SeanHsu324/ES/樹莓派.md

# 樹莓派 5 使用手冊

大老二 AI 機器手臂在樹莓派 5 上的接線、啟動、Discord `/` 指令與疑難排解。
（Windows 端的錄製與開發流程請看 [README.md](README.md)）

---

## 1. 系統架構

```
                       ┌──────────── 樹莓派 5 ────────────┐
 手牌鏡頭 (USB) ──────►│                                   │
 出牌區鏡頭 (USB) ────►│  main.py                          │──HDMI──► 外接螢幕 (觀眾畫面)
 PASS 按鈕 ──GPIO17──►│   ├ 影像辨識 (手牌、出牌區)         │
                       │   ├ AI 決策 (big_two_best.pth)     │──網路──► Discord
                       │   └ 手臂控制 ──I2C──┐              │          ├ 後臺頻道
                       └─────────────────────┼─────────────┘          └ 牌局頻道
                                             ▼
                                  PCA9685 伺服驅動板
                                  ├ 通道 0~5：手臂 J1~J6
                                  └ 通道 6、7：排夾 J7、J8
```

樹莓派版**不需要 ESP32 和示範臂**：樹莓派用 I2C 直接控制 PCA9685。
動作已經在 Windows + ESP32 + 示範臂錄好，複製過來直接用。樹莓派版**不能錄製新動作**。

---

## 2. 接線

### 2.1 樹莓派 40pin 腳位（只列出會用到的）

**pin 1** 在 40pin 排針**離 USB 孔最遠的那一端、靠板子內側的那一排**（背面焊墊是方形的那一腳）。
奇數腳（1、3、5…）在內側那排，偶數腳（2、4、6…）在靠板子邊緣那排。
不確定的話，在樹莓派終端機輸入 **`pinout`**，會直接畫出這塊板子的腳位圖。

```
           3.3V  (1) ●  ● (2)  5V
  SDA  GPIO2     (3) ●  ● (4)  5V
  SCL  GPIO3     (5) ●  ● (6)  GND
                 (7) ●  ● (8)
            GND  (9) ●  ● (10)
  PASS GPIO17   (11) ●  ● (12)
                     …
```

### 2.2 PCA9685 伺服驅動板

| PCA9685 腳位 | 接到 | 說明 |
|---|---|---|
| **VCC** | 樹莓派 **pin 1（3.3V）** | 驅動板晶片本身的電源（邏輯電壓） |
| **GND** | 樹莓派 **pin 6（GND）** | |
| **SDA** | 樹莓派 **pin 3（GPIO2）** | I2C 資料線 |
| **SCL** | 樹莓派 **pin 5（GPIO3）** | I2C 時脈線 |
| **V+**（綠色端子台） | **外接 5~6V 電源的 +** | 伺服馬達的電源 |
| **GND**（綠色端子台） | **外接電源的 −** | 要和樹莓派**共地**（見下方） |

> ⚠️ **伺服馬達絕對不能從樹莓派取電。** 8 顆伺服同時動，電流會到好幾安培，會讓樹莓派重開機甚至燒壞。
> ⚠️ **一定要共地**：外接電源的 − 和樹莓派的 GND 要相通。PCA9685 板子上兩個 GND 本來就是連通的，所以把 GND 接到樹莓派 pin 6 就完成共地了。
> ⚠️ VCC 接 **3.3V（pin 1）**，不要接 5V。I2C 訊號是 3.3V，接 5V 可能傷到樹莓派的 GPIO。

### 2.3 伺服馬達（接在 PCA9685 上）

| PCA9685 通道 | 馬達 | 說明 |
|---|---|---|
| 0 | J1 | 底座旋轉 |
| 1 | J2 | 大臂 |
| 2 | J3 | 小臂 |
| 3 | J4 | 腕俯仰 |
| 4 | J5 | 腕旋轉 |
| 5 | J6 | 夾爪 |
| 6 | J7 | 第一排排夾（0° 開、90° 關） |
| 7 | J8 | 第二排排夾（90° 開、0° 關） |

插頭方向：**咖啡色（或黑色）線 = GND**，對準 PCA9685 排針上標示 GND 的那一排。紅色 = V+，橘色（或黃色）= 訊號。

### 2.4 PASS 按鈕（自回彈按鈕）

| 按鈕 | 接到 |
|---|---|
| 一腳 | 樹莓派 **pin 11（GPIO17）** |
| 另一腳 | 樹莓派 **pin 9（GND）** |

不用另外加電阻，程式會開啟樹莓派內建的上拉電阻。

### 2.5 鏡頭

兩顆 USB 鏡頭直接插樹莓派的 USB 孔，建議插**藍色的 USB 3.0 孔**，頻寬比較夠。
- 手牌鏡頭：裝在手臂上，拍手牌架。
- 出牌區鏡頭：拍出牌區。

如果兩顆讀反了，用 Discord 的 **`/swapcam`** 互換就好，不用改接線（見第 5 節）。

### 2.6 接好後檢查

在樹莓派的終端機執行：
```bash
i2cdetect -y 1
```
表格裡出現 **`40`**，代表 PCA9685 有接好。全部都是 `--` 的話，請檢查 SDA / SCL 有沒有接反，以及 VCC、GND。

---

## 3. 開機與啟動

### 3.1 已經設定好的系統項目
| 項目 | 狀態 |
|---|---|
| I2C | 已開啟（`/boot/firmware/config.txt`：`dtparam=i2c_arm=on`） |
| 風扇 | 開機就全速轉（同一個檔案最後面的 `BIGTWO_FAN` 區塊） |
| Python 環境 | `~/ES/venv`（PyTorch、OpenCV、Discord 等都裝好了） |
| 程式位置 | `~/ES` |
| 桌面捷徑 | 桌面上的 **「大老二 AI」** |

原本的 `config.txt` 備份在 `/boot/firmware/config.txt.bak-日期`。

### 3.2 啟動
1. **先開伺服馬達的外接電源**，再開樹莓派（或已開機也可以）。
2. 雙擊桌面的 **「大老二 AI」**。
3. 會開一個終端機視窗（顯示系統訊息），外接螢幕則全螢幕顯示**觀眾畫面**。
4. Discord 上機器人 `A2C手臂` 會上線，後臺頻道會開始出現訊息。

> ⚠️ 伺服板**剛上電**時，程式不知道手臂在哪，第一個動作（回初始點）會**直接跳到定位**。啟動前手要離開手臂。
> 之後只要伺服板一直有電，重開程式時會讀回上次的角度，從原位平滑出發。

### 3.3 關閉
- Discord 輸入 **`/shutdown`**，或
- 在終端機視窗按 **Ctrl+C**。

程式結束後，終端機會顯示「按 Enter 關閉視窗」。

---

## 4. 觀眾畫面（外接螢幕）

給所有人看的遊戲畫面，**不顯示任何人的手牌**：

| 位置 | 內容 |
|---|---|
| 左上角 | **紅黃綠狀態燈** |
| 上下左右 | 4 家（AI / P2 / P3 / P4）的牌背和**剩餘張數** |
| 中間 | 出牌區**已出過的總張數** |
| 右下角 | 出牌區鏡頭即時畫面 |

- **輪到誰**：那一家的數字外圈會發金光。
- **PASS**：這一回合已經 Pass 的人會標 `PASS`。
- **獲勝**：出完牌的人旁邊會出現皇冠。

### 狀態燈
| 燈號 | 意思 | 要做什麼 |
|---|---|---|
| 🟢 綠 | 全自動正常進行中 | 不用管 |
| 🟡 黃 | 處理中（手臂動作、拍照、辨識），或還沒開始全自動、等你確認 | 照 Discord 提示操作，或等它跑完 |
| 🔴 紅 | **需要人處理**：緊急停止中、手臂驅動板沒接上、出牌區鏡頭沒畫面 | 看後臺頻道的訊息，排除問題 |

### 現場緊急停止
Discord 會有延遲，所以保留一個實體按鍵：在觀眾畫面上按 **`Esc`**，手臂立刻停止。
解除要用 Discord 的 `/resume`。

---

## 5. Discord `/` 指令

### 5.1 頻道
| 頻道 | 用途 |
|---|---|
| **後臺** `#後台-bot` | 所有系統訊息（等於終端機的輸出）、錯誤、辨識結果 |
| **牌局** `#局` | 公開的出牌紀錄，例如「P2 出牌 ♠9 ♥9（剩 11 張）」。**開新局時會清空** |

- **誰能用指令**：只有擁有**主人身分組（@呵）**的成員可以使用。其他人使用會看到「只有主人可以使用這個指令」。
- **回覆可見範圍**：所有指令的回覆**只有下指令的人看得到**，所以在牌局頻道下指令也不會洗版。

### 5.2 開局用
| 指令 | 說明 |
|---|---|
| **`/newgame`** | 開新局：**清空牌局頻道**、重設所有狀態、**打開排夾**（讓你插牌） |
| **`/start`** | 手臂依序到第一排、第二排拍照辨識手牌 → 回初始點 → **排夾關閉** → 辨識完整就**自動開始全自動對戰**。手牌已經鎖定時，直接開始全自動 |
| `/start first:P2` | 同上，並直接指定「AI 沒有梅花 3 時，誰先出」 |
| **`/first player`** | AI 沒有梅花 3 時，指定誰有梅花 3（P2 / P3 / P4） |
| `/scan` | 只拍照辨識手牌，不自動開始（想先檢查辨識結果時用） |
| `/fix slot card` | 修正辨識錯的某一格，例如 `slot:5 card:SA`。牌名規則見 5.6 |
| `/confirm` | 確認手牌（`/scan` + `/fix` 之後用），會關閉排夾 |

### 5.3 對戰中
| 指令 | 說明 |
|---|---|
| `/auto on:True` / `/auto on:False` | 全自動開 / 關 |
| `/read` | 手動模式：辨識出牌區的牌，結果顯示在後臺 |
| `/submit` | 手動模式：把 `/read` 辨識到的牌，當成現在輪到的對手出的牌 |
| `/aiplay` | 手動模式：輪到 AI 時，讓 AI 出牌 |

### 5.4 Pass 按鈕（取代 `/pass`）
每次換人，牌局頻道會公告「👉 輪到 P3」。輪到對手時，下面附一顆 **✋ Pass 按鈕**，按下就是那一家 Pass。
- 換人之後，上一則的按鈕會自動消失；按到過期的按鈕會回覆「已經過期」，不會誤判。
- 預設只有主人身分組能按。要讓頻道裡所有人都能按，把 `config.py` 的 `DISCORD_PASS_BUTTON_ANYONE` 改成 `True`。

```
👉 輪到 P3
[ ✋ Pass ]      ← 按這個 = P3 Pass
```

### 5.5 系統
| 指令 | 說明 |
|---|---|
| **`/stop`** | ⛔ **緊急停止**：手臂停在原地，全自動關閉 |
| `/resume` | 解除緊急停止，手臂回到初始點。全自動要再用 `/start` 開啟 |
| `/clamp action` | 排夾開 / 關（全自動中不能開） |
| **`/status`** | 查看系統狀態：燈號、手臂、排夾、鏡頭編號、輪到誰、4 家張數、上一手、**AI 手牌**（只有你看得到） |
| **`/swapcam`** | **手牌鏡頭和出牌區鏡頭互換**。兩顆 USB 鏡頭讀反時用，會自動存進 `.env`，下次開機也是對的 |
| `/shutdown` | 關閉主程式 |

### 5.6 牌名規則（`/fix` 用）
花色字母 + 點數，例如：
- 花色：`C` 梅花、`D` 方塊、`H` 紅心、`S` 黑桃
- 點數：`3 4 5 6 7 8 9 10 J Q K A 2`（10 可以打 `10` 或 `T`）
- 例：`C3` 梅花 3、`H10` 紅心 10、`SA` 黑桃 A、`D2` 方塊 2

### 5.7 一局的標準流程
1. `/newgame`：牌局頻道清空，排夾打開。
2. 把 13 張牌插進手牌架：**第一排 8 張、第二排 5 張**。
3. `/start`：自動拍照辨識，完成後開始全自動。
   - AI 沒有梅花 3 → 後臺會提示，用 `/first` 指定。
   - 辨識有錯 → 後臺會提示，用 `/status` 看、`/fix` 改、`/confirm` 確認，再 `/start`。
4. 對戰：
   - 輪到 AI：手臂自動夾牌、往前丟。
   - 輪到對手：對手把牌**正面朝上**放進出牌區、手移開，系統自動辨識。
   - 對手要 Pass：按實體 **PASS 按鈕**，或按牌局頻道「輪到 Px」下面的 **✋ Pass**。出牌區 15 秒沒動靜也會自動判 Pass。
5. 有人出完牌 → 觀眾畫面顯示皇冠，牌局頻道公布獲勝者。
6. 下一局回到步驟 1。

---

## 6. 檢查鏡頭有沒有讀反

1. 啟動後看觀眾畫面**右下角**：應該是**出牌區**的畫面。
2. 如果顯示的是手牌架（手臂上的鏡頭畫面）→ 在 Discord 打 **`/swapcam`**。
3. `/status` 會顯示目前兩顆鏡頭的編號，例如「鏡頭：手牌 2 ✅ / 出牌區 0 ✅」。

鏡頭設定存在 `~/ES/.env` 的 `HAND_CAMERA`、`PLAY_CAMERA` 這兩行。

---

## 7. 更新程式

在 **Windows** 的 ES 資料夾執行：
```powershell
powershell -File pi\deploy.ps1 -PiHost pi.local
```
- `pi.local` 連不到時，改用樹莓派的 IP。在樹莓派終端機輸入 `hostname -I` 可以查到。
- 樹莓派上的 `.env`（金鑰、Discord token、鏡頭設定）**不會被覆蓋**。真的要覆蓋，加 `-CopyEnv`。
- 桌面捷徑也會一起更新。
- 更新後要重新啟動「大老二 AI」才會生效。

---

## 8. 疑難排解

| 狀況 | 原因 / 處理 |
|---|---|
| 狀態燈紅色，後臺說「找不到 PCA9685」 | 驅動板沒接好。執行 `i2cdetect -y 1` 看有沒有 `40`，檢查 SDA / SCL / VCC / GND（第 2.2 節） |
| 狀態燈紅色，鏡頭開不起來 | USB 鏡頭沒插好，或編號不對。`/status` 看是哪一顆 ❌ |
| 觀眾畫面右下角是手牌架 | 鏡頭讀反了，用 `/swapcam` |
| 手臂動到一半樹莓派重開機 / 後臺說「ESP32 重新開機」 | 伺服電源不夠，或伺服電源和樹莓派共用。換更大的外接電源，並確認伺服沒有從樹莓派取電 |
| 手臂抖動、沒力 | 外接電源電壓或電流不足（建議 5~6V、5A 以上） |
| `/` 指令打不出來 | 機器人沒上線：確認「大老二 AI」有在跑、樹莓派有連網路。剛開機要等十幾秒 |
| 指令回覆「只有主人可以使用」 | 你的帳號沒有 **@呵** 身分組 |
| `/newgame` 沒有清空牌局頻道 | 機器人需要「管理訊息」權限 |
| 對手出牌沒被偵測到 | 牌要正面朝上、手要移開。還是不行就用 `/read` + `/submit` 手動輸入 |
| 還沒出牌就被判 Pass | 對手 15 秒內沒有動作。可以在 `main.py` 調高 `PASS_TIMEOUT_SEC` |
| 辨識一直失敗 | 網路斷線或辨識服務忙線。技術細節在 `~/ES/logs/vision.log` |
| 風扇不轉 / 不是全速 | 檢查 `config.txt` 最後的 `BIGTWO_FAN` 區塊，改完要重開機 |

### 常用檔案位置
| 檔案 | 位置 |
|---|---|
| 程式 | `~/ES/` |
| 個人設定（金鑰、token、鏡頭） | `~/ES/.env`（不要分享給別人） |
| 動作檔 | `~/ES/actions/` |
| 拍手牌的照片 | `~/ES/webcam_snapshots/` |
| 辨識紀錄 | `~/ES/logs/vision.log` |
| 系統開機設定 | `/boot/firmware/config.txt` |

---

## 9. 安全提醒
- **伺服電源一定外接**，絕對不從樹莓派取電。
- 啟動程式前，手要離開手臂。
- 有任何異常，馬上按觀眾畫面的 **`Esc`**，或用 Discord 的 **`/stop`**。
- `.env` 裡有 Gemini 金鑰和 Discord token，**不要上傳或分享**。
- sudo 密碼曾經貼在對話裡，建議用 `passwd` 改掉。
