SeanHsu324/ES/vision.py

"""
鏡頭 + Gemini 辨識 (main.py / record.py 共用)
"""
import os
import sys
import json
import time
import threading

import cv2
import numpy as np

from config import (
    CAMERA_WIDTH, CAMERA_HEIGHT, GEMINI_MODELS, GEMINI_TIMEOUT_SEC, HAND_ROI, PLAY_ROI,
    HAND_ZONES, NUM_SLOTS, PHOTO_SETTLE_SEC, HAND_REVERSED, SNAPSHOT_DIR,
)
from robot_arm import HOME
from config import BASE_DIR

# 辨識服務的技術細節 (模型、回應時間、錯誤) 只寫進本機 logs/vision.log，不顯示在終端機 / Discord
import logging
os.makedirs(os.path.join(BASE_DIR, 'logs'), exist_ok=True)
vlog = logging.getLogger('vision')
vlog.setLevel(logging.INFO)
vlog.propagate = False
if not vlog.handlers:
    _h = logging.FileHandler(os.path.join(BASE_DIR, 'logs', 'vision.log'), encoding='utf-8')
    _h.setFormatter(logging.Formatter('%(asctime)s %(levelname)s %(message)s'))
    vlog.addHandler(_h)

# =====================================================
# 牌名 <-> 編號
# =====================================================
# 0-12: 梅花(C), 13-25: 方塊(D), 26-38: 紅心(H), 39-51: 黑桃(S)
SUIT_ORDER = ['C', 'D', 'H', 'S']
RANK_ORDER = ['3', '4', '5', '6', '7', '8', '9', 'T', 'J', 'Q', 'K', 'A', '2']
CARD_NAMES = [s + r for s in SUIT_ORDER for r in RANK_ORDER]  # 規定名稱，例: C3, DT, SA, H2


def get_card_id(name):
    """牌名 -> 1~52，無法辨識回傳 None"""
    if not isinstance(name, str):
        return None
    name = name.strip().upper().replace('10', 'T')
    if len(name) != 2:
        return None
    s, r = name[0], name[1]
    if s not in SUIT_ORDER or r not in RANK_ORDER:
        return None
    return SUIT_ORDER.index(s) * 13 + RANK_ORDER.index(r) + 1


def id_to_card_name(card_id):
    if not (1 <= card_id <= 52): return "??"
    return f"{SUIT_ORDER[(card_id-1)//13]}{RANK_ORDER[(card_id-1)%13]}"


def names_str(ids):
    return " ".join(id_to_card_name(c) for c in sorted(ids))


def crop(frame, roi):
    if roi is None:
        return frame
    h, w = frame.shape[:2]
    x, y, rw, rh = roi
    return frame[int(y*h):int((y+rh)*h), int(x*w):int((x+rw)*w)]


def draw_roi(img, roi, color):
    if roi is None:
        return
    h, w = img.shape[:2]
    x, y, rw, rh = roi
    cv2.rectangle(img, (int(x*w), int(y*h)), (int((x+rw)*w), int((y+rh)*h)), color, 2)


def put_text(img, text, y, scale, color, thick, x=20):
    cv2.putText(img, text, (x, y), cv2.FONT_HERSHEY_PLAIN, scale, color, thick)


# =====================================================
# 鏡頭 (背景持續讀取，永遠拿到最新畫面)
# =====================================================
def _camera_backend():
    # Windows: DirectShow；樹莓派 / Linux: V4L2
    return cv2.CAP_DSHOW if sys.platform == 'win32' else cv2.CAP_V4L2


class Camera:
    def __init__(self, index, name):
        self.index = index
        self.name = name
        self.cap = None
        self.ok = False
        self._frame = None
        self._frame_time = 0.0
        self._lock = threading.Lock()
        self._running = False
        if index is None:
            print(f"[鏡頭] {name} 未設定，略過")
            return
        # index 可以是編號 (0, 1, 2…) 或 Linux 裝置路徑 (/dev/v4l/by-id/...)
        self.cap = cv2.VideoCapture(index, _camera_backend())
        # MJPG 壓縮：兩顆 USB 鏡頭同時跑 1280x720 未壓縮畫面時頻寬不夠，會卡頓
        self.cap.set(cv2.CAP_PROP_FOURCC, cv2.VideoWriter_fourcc(*'MJPG'))
        self.cap.set(cv2.CAP_PROP_FRAME_WIDTH, CAMERA_WIDTH)
        self.cap.set(cv2.CAP_PROP_FRAME_HEIGHT, CAMERA_HEIGHT)
        self.ok = self.cap.isOpened()
        self._running = self.ok
        if self.ok:
            threading.Thread(target=self._loop, daemon=True).start()
            print(f"[鏡頭] {name} (編號 {index}) 已開啟")
        else:
            print(f"[鏡頭] ❌ {name} (編號 {index}) 開不起來，請用 record.py 的 cams 指令確認編號")

    def _loop(self):
        while self._running:
            try:
                ret, frame = self.cap.read()
            except cv2.error:
                ret, frame = False, None
            if ret and frame is not None and frame.size > 0:
                with self._lock:
                    self._frame = frame
                    self._frame_time = time.time()
            else:
                time.sleep(0.01)

    def age(self):
        """距離上一張新畫面幾秒 (鏡頭卡住或被拔掉時會一直變大)"""
        return time.time() - self._frame_time if self._frame_time else float('inf')

    def read(self):
        """最新畫面 (可能為 None)"""
        with self._lock:
            return None if self._frame is None else self._frame.copy()

    def fresh(self, timeout=2.0):
        """等一張「呼叫之後才拍到」的畫面 (手臂剛停下時用，避免拿到移動中的舊畫面)"""
        t0 = time.time()
        while time.time() - t0 < timeout:
            with self._lock:
                if self._frame is not None and self._frame_time > t0 + 0.05:
                    return self._frame.copy()
            time.sleep(0.01)
        return self.read()

    def release(self):
        self._running = False
        time.sleep(0.05)
        if self.cap is not None:
            self.cap.release()


def probe_cameras(max_index=6, skip=()):
    """
    列出可以開啟的鏡頭。
    Windows: 編號 0~max_index；Linux: /dev/v4l/by-id/ 下的 USB 鏡頭 (固定名稱，建議寫進 .env)
    """
    if sys.platform == 'win32':
        candidates = list(range(max_index))
    else:
        import glob
        candidates = sorted(glob.glob('/dev/v4l/by-id/*-video-index0')) or \
            sorted(glob.glob('/dev/video*'), key=lambda d: int(d[len('/dev/video'):] or 0))[:12]
    found = []
    for dev in candidates:
        if dev in skip:
            found.append((dev, '使用中'))
            continue
        cap = cv2.VideoCapture(dev, _camera_backend())
        if cap.isOpened():
            ret, frame = cap.read()
            if ret:
                found.append((dev, f"{frame.shape[1]}x{frame.shape[0]}"))
        cap.release()
    return found


# =====================================================
# Gemini 辨識 (只在需要時呼叫)
# =====================================================
RULES = (
    "Card naming rule: suit letter + rank letter, exactly 2 characters.\n"
    "Suits: C=Clubs, D=Diamonds, H=Hearts, S=Spades.\n"
    "Ranks: 3 4 5 6 7 8 9 T(=10) J Q K A 2.\n"
    "Examples: 'C3' = 3 of clubs, 'DT' = 10 of diamonds, 'SA' = ace of spades, 'H2' = 2 of hearts.\n"
)

HAND_PROMPT = (
    "This image shows exactly {n} playing cards standing upright, face visible, in a single row "
    "inside a card holder rack. Cards may overlap slightly; read the rank/suit index in each card's corner.\n"
    + RULES +
    "List every card strictly from LEFT to RIGHT as they appear in the image. "
    "The array must have exactly {n} entries, one per card position, no duplicates. "
    "Return only the JSON array."
)

PLAY_PROMPT = (
    "This image shows the play area of a card game table.\n"
    + RULES +
    "List every distinct face-up card whose rank and suit you can identify, from left to right. "
    "Return only the JSON array. If there are no cards, return []."
)


class GeminiCardReader:
    def __init__(self, models=GEMINI_MODELS):
        from google import genai
        from google.genai import types
        self.types = types
        api_key = os.environ.get('GEMINI_API_KEY', '').strip()   # config.py 已從 .env 載入
        if not api_key:
            raise RuntimeError("找不到 GEMINI_API_KEY，請在 ES/.env 寫入一行 GEMINI_API_KEY=你的key")
        # 不讓 SDK 自己重試 (伺服器忙線時會卡好幾分鐘)，改由這裡換模型
        self.client = genai.Client(api_key=api_key, http_options=types.HttpOptions(
            timeout=int(GEMINI_TIMEOUT_SEC * 1000),
            retry_options=types.HttpRetryOptions(attempts=1),
        ))
        self.models = list(models)
        self.model = self.models[0]   # 最近一次成功的模型，下次優先用
        self.schema = types.Schema(
            type=types.Type.ARRAY,
            items=types.Schema(type=types.Type.STRING, enum=CARD_NAMES),
        )

    def _ask(self, image, prompt):
        ok, jpg = cv2.imencode('.jpg', image, [cv2.IMWRITE_JPEG_QUALITY, 90])
        if not ok:
            raise RuntimeError("影像編碼失敗")
        types = self.types
        contents = [types.Part.from_bytes(data=jpg.tobytes(), mime_type='image/jpeg'), prompt]
        config = types.GenerateContentConfig(
            response_mime_type='application/json',
            response_schema=self.schema,
            thinking_config=types.ThinkingConfig(thinking_level='low'),  # 認牌不需要深度思考，快很多
        )
        order = [self.model] + [m for m in self.models if m != self.model]
        errors = []
        for model in order:
            t0 = time.time()
            try:
                resp = self.client.models.generate_content(model=model, contents=contents, config=config)
                names = [n.strip().upper() for n in json.loads(resp.text)]
            except Exception as e:
                msg = str(e).split('.')[0][:80]
                errors.append(f"{model}: {msg}")
                vlog.warning(f"{model} 失敗 ({time.time()-t0:.0f}s): {msg}")
                continue
            if model != self.model:
                vlog.info(f"改用 {model}")
                self.model = model
            vlog.info(f"{model} 回應 {time.time()-t0:.1f}s -> {names}")
            return names
        vlog.error("全部失敗: " + " | ".join(errors))
        raise RuntimeError("辨識服務暫時無法使用，請稍後再試")

    def read_hand(self, frame, n):
        """回傳該排由左到右的牌名陣列 (長度應為 n)"""
        return self._ask(crop(frame, HAND_ROI), HAND_PROMPT.format(n=n))

    def read_played(self, frame):
        """回傳出牌區看得到的所有牌名"""
        return self._ask(crop(frame, PLAY_ROI), PLAY_PROMPT)


def save_snapshot(frame, tag):
    os.makedirs(SNAPSHOT_DIR, exist_ok=True)
    path = os.path.join(SNAPSHOT_DIR, f"{tag}_{time.strftime('%Y%m%d_%H%M%S')}.jpg")
    cv2.imwrite(path, frame)
    return path


def capture_zone(robot, hand_cam, zone):
    """手臂移到該排拍照點 -> 等穩定 -> 拍照。失敗回傳 None"""
    pose = zone['pose']
    if not robot.has_action(pose):
        print(f"[手牌] ❌ 缺少拍照點 {pose}，請用 record.py 設定")
        return None
    if not robot.run_sequence([pose], return_home=False):
        return None
    robot.wait()
    if robot.abort.is_set() or not robot.last_ok:
        print(f"[手牌] ❌ 手臂沒有到達拍照點 {pose}，停止辨識 (請檢查手臂與電源)")
        return None
    time.sleep(PHOTO_SETTLE_SEC)
    frame = hand_cam.fresh()
    if frame is not None:
        save_snapshot(frame, pose)
    return frame


def read_zone(reader, frame, zone):
    names = reader.read_hand(frame, zone['count'])
    print(f"[影像辨識] {zone['label']} 由左到右: {names}")
    names = (names + ['??'] * zone['count'])[:zone['count']]
    return names[::-1] if HAND_REVERSED else names


def scan_hand(robot, hand_cam, reader):
    """
    依序到每一排的拍照點拍照並辨識，回初始點後關閉排夾。
    回傳 (13 個牌名，依格子 1~13 排列, 是否完整可用)；手臂中斷回傳 (None, False)
    """
    all_names = []
    for zone in HAND_ZONES:
        frame = capture_zone(robot, hand_cam, zone)
        if frame is None:
            return None, False
        all_names += read_zone(reader, frame, zone)
    if robot.has_action(HOME):
        robot.run_sequence([HOME], return_home=False)
        robot.wait()
    if robot.abort.is_set():
        return None, False
    robot.close_clamps()   # 拍完兩排、回到初始點 -> 夾住手牌

    ids = [get_card_id(n) for n in all_names]
    valid = None not in ids and len(set(ids)) == NUM_SLOTS
    if not valid:
        print("[警告] 手牌辨識不完整或有重複，可重新辨識，或按 E 手動修改後按 Y")
    return all_names, valid
